ghmartin77/KidsMP3Player/assets/Manual German.pdf

# Kid‘s MP3 Player

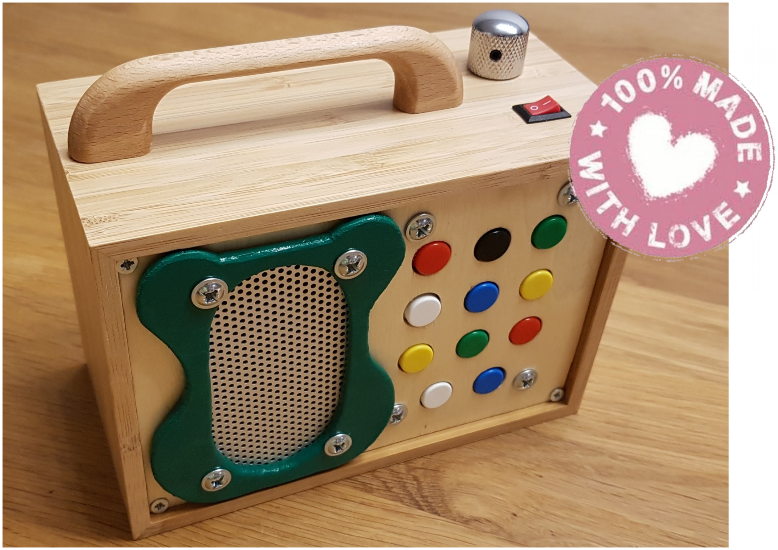
[picture p16: figure]

# Und so geht‘s

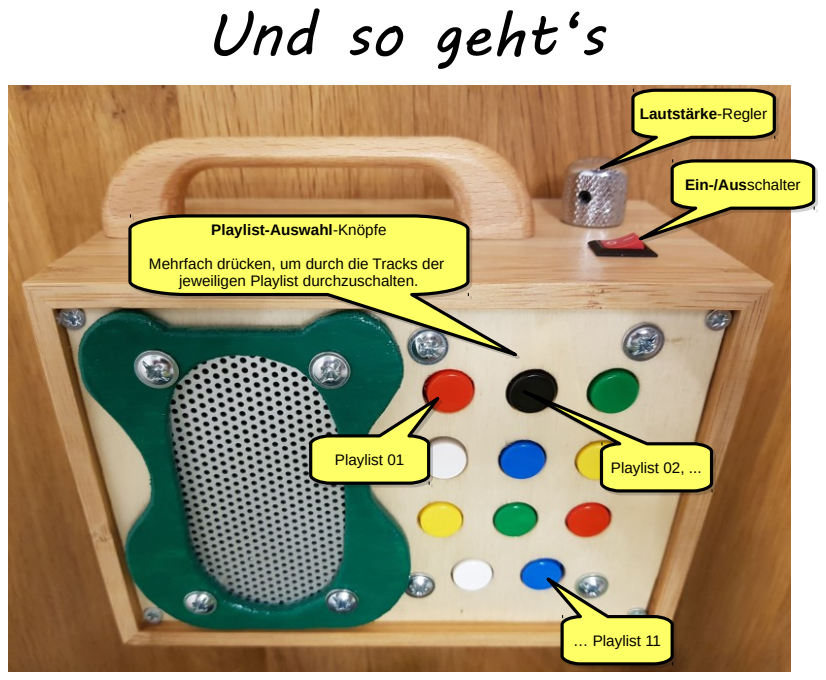
[picture p17: page 2]
Playlist 01 Playlist 01; Playlist 02, ... Playlist 02, ...; … … Playlist 11 Playlist 11

Lautstärke Lautstärke-Regler -Regler

Ein-/Aus Ein-/Ausschalter schalter

Playlist-Auswahl-Knöpfe

Mehrfach drücken, um durch die Tracks der
jeweiligen Playlist durchzuschalten.

# Nur noch 5 Minuten, bütte!

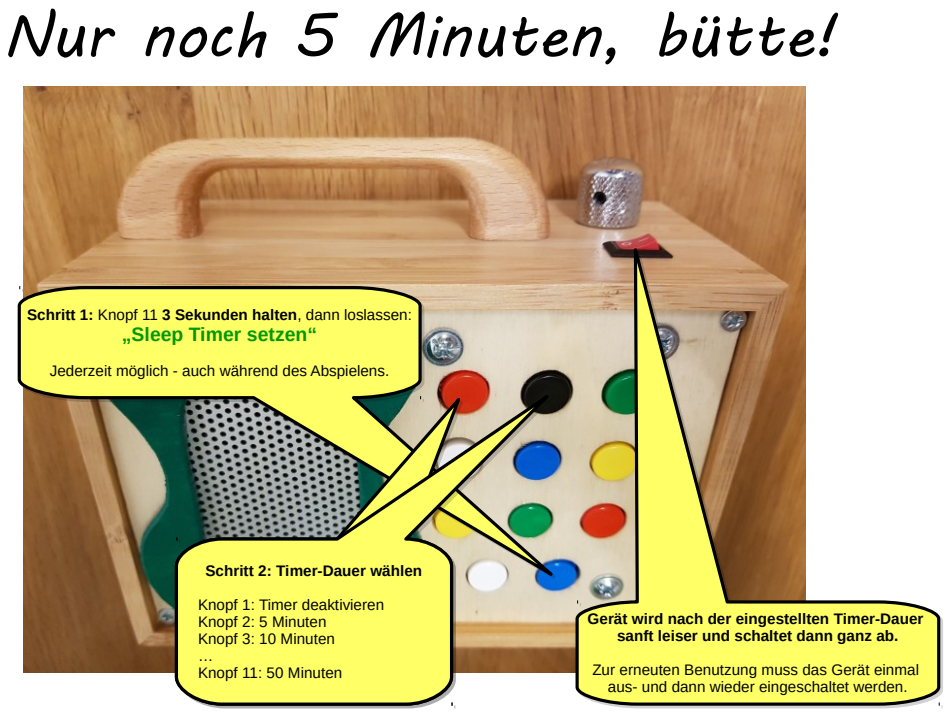
[picture p18: page 3]
Knopf 1: Aus; Knopf 2: 5 Minuten Knopf 3: 10 Minuten; Knopf 11: 50 Minuten

Schritt 1: Knopf 11 3 Sekunden halten, dann loslassen:

„Sleep Timer setzen“

Jederzeit möglich - auch während des Abspielens.

Schritt 2: Timer-Dauer wählen
Knopf 1: Timer deaktivieren
Knopf 2: 5 Minuten
Knopf 3: 10 Minuten
Knopf 11: 50 Minuten

Gerät wird nach der eingestellten Timer-Dauer
sanft leiser und schaltet dann ganz ab.
Zur erneuten Benutzung muss das Gerät einmal
aus- und dann wieder eingeschaltet werden.

# Spiel‘s noch einmal, Sam

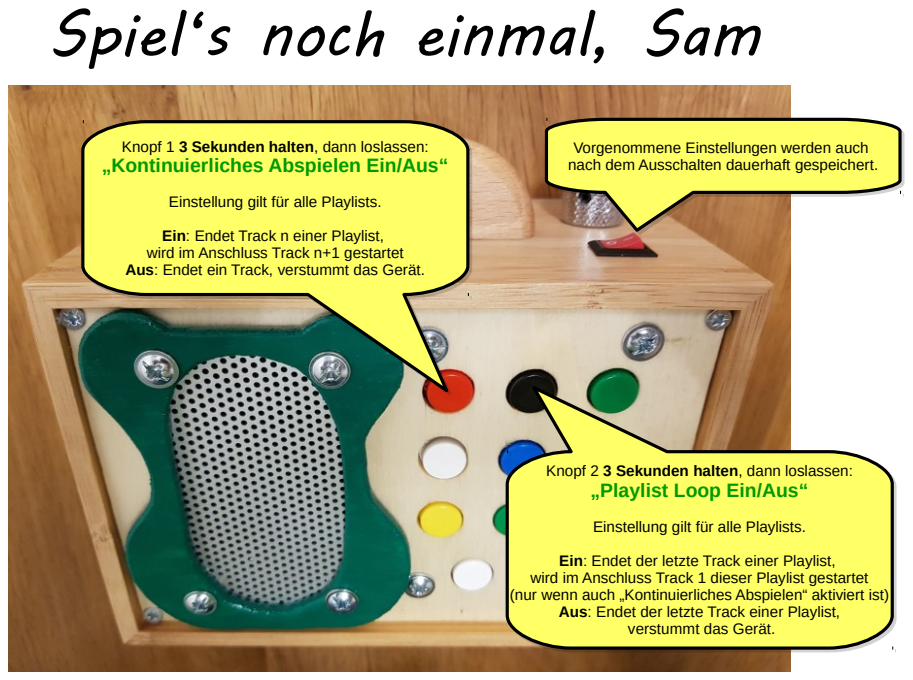
[picture p19: page 4]

Knopf 1 3 Sekunden halten, dann loslassen:
„Kontinuierliches Abspielen Ein/Aus“

Vorgenommene Einstellungen werden auch
nach dem Ausschalten dauerhaft gespeichert.

Einstellung gilt für alle Playlists.
Ein: Endet Track n einer Playlist,
wird im Anschluss Track n+1 gestartet
Aus: Endet ein Track, verstummt das Gerät.

Knopf 2 3 Sekunden halten, dann loslassen:
„Playlist Loop Ein/Aus“

Ein: Endet der letzte Track einer Playlist,
wird im Anschluss Track 1 dieser Playlist gestartet
(nur wenn auch „Kontinuierliches Abspielen“ aktiviert ist)
Aus: Endet der letzte Track einer Playlist,

verstummt das Gerät.

# Offen für alles

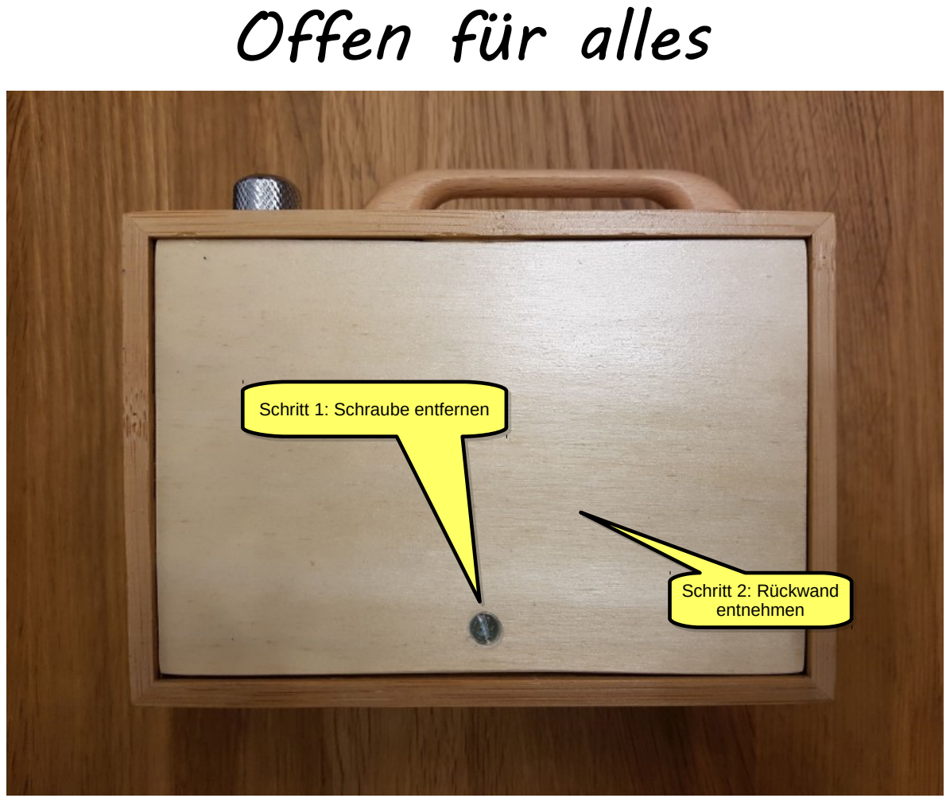
[picture p20: page 5]

Schritt 2: Rückwand
entnehmen

Schritt 2: Rückwand
entnehmen

Schritt 1: Schraube entfernen Schritt 1: Schraube entfernen

# Bin Laden

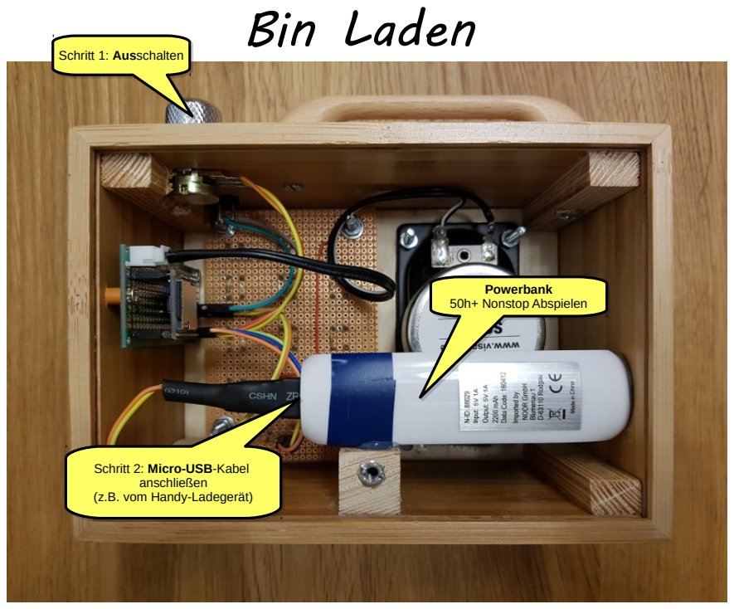
[picture p21: page 6]
anschließen; Powerbank 50h+ Nonstop Abspielen

Schritt 1: Schritt 1: Aus Ausschalten schalten

Schritt 2: Micro-USB-Kabel
(z.B. vom Handy-Ladegerät)

# Sattgehört?

MicroSD-Karte, auf der die Playlists gespeichert sind. Zum Auswerfen und Einsetzen jeweils leicht eindrücken.

ACHTUNG!!! Zuvor Gerät ausschalten!

SD-Adapter-Karte für PC-Reader liegt bei.

MicroSD-Karte, auf der die Playlists gespeichert sind. Zum Auswerfen und Einsetzen jeweils leicht eindrücken.

ACHTUNG!!! Zuvor Gerät ausschalten!

SD-Adapter-Karte für PC-Reader liegt bei.

Ordnerstruktur

\01\ | Ordner für Tracks der Playlist 1
001.mp3 | Track 1 der Playlist 1
002.mp3 | Track 2 der Playlist 1
…
\02\ | Ordner für Tracks der Playlist 2
001.mp3 | Track 1 der Playlist 2
002.mp3 | Track 2 der Playlist 2
…
…
\11\ | Ordner für Tracks der Playlist 11
001.mp3 | Track 1 der Playlist 11

Die Ordnernamen der Playlists dürfen nicht verändert werden! Die Dateinamen der Tracks innerhalb der Playlist müssen dem Namensschema
<dreistellige Nummer mit führenden Nullen>.mp3 entsprechen und je Playlist-Ordner von 1 beginnend hochgezählt werden.

Ordnerstruktur

\01\ | Ordner für Tracks der Playlist 1
001.mp3 | Track 1 der Playlist 1
002.mp3 | Track 2 der Playlist 1
…
\02\ | Ordner für Tracks der Playlist 2
001.mp3 | Track 1 der Playlist 2
002.mp3 | Track 2 der Playlist 2
…
…
\11\ | Ordner für Tracks der Playlist 11
001.mp3 | Track 1 der Playlist 11

Die Ordnernamen der Playlists dürfen nicht verändert werden! Die Dateinamen der Tracks innerhalb der Playlist müssen dem Namensschema
<dreistellige Nummer mit führenden Nullen>.mp3 entsprechen und je Playlist-Ordner von 1 beginnend hochgezählt werden.

# Have It Your Way

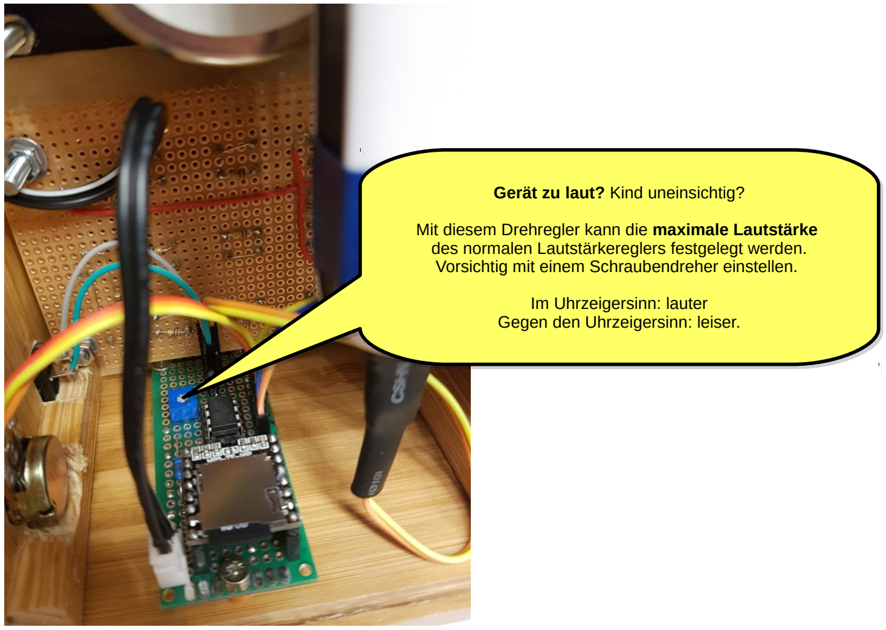
[picture p22: figure]
Gerät zu laut? Kind uneinsichtig?; des normalen Lautstärkereglers festgelegt werden. Vorsichtig mit einem Schraubendreher einstellen.; Im Uhrzeigersinn: lauter Gegen den Uhrzeigersinn: leiser.

Mit diesem Drehregler kann die maximale Lautstärke

Mit diesem Drehregler kann die maximale Lautstärke

# Your Style, Your Rules

Konfigurationsansagen von Tante Google zu hölzern?

Einfach die Dateien unter \ADVERT und \MP3 durch selbst gesprochene Texte austauschen. Dabei Dateinamen und Aussageinhalt beibehalten.

Dateien in \ADVERT und \MP3 müssen identisch sein. Daher Dateien in einem der Ordner aktualisieren und im Anschluss in den anderen Ordner kopieren.

Konfigurationsansagen von Tante Google zu hölzern?

Einfach die Dateien unter \ADVERT und \MP3 durch selbst gesprochene Texte austauschen. Dabei Dateinamen und Aussageinhalt beibehalten.

Dateien in \ADVERT und \MP3 müssen identisch sein. Daher Dateien in einem der Ordner aktualisieren und im Anschluss in den anderen Ordner kopieren.
