ghmartin77/KidsMP3Player/(threads)

Thread 1 (2020-08-25):

pin vol/key swapped?

jlarsch, 2020-08-25:
Hi, nice project. Looking at your code and circuit I get the impression you swapped the pin for volume vs. keys? In the code, you define PIN_KEY A3 but the circuit suggests A3 is connected to potentiometer - and vice versa.

jlarsch, 2020-08-25:
or maybe I misunderstood attiny pin naming?

Thread 2 (2024-04-03):

Using Digispark clone board with ATTinyCore bootloader: Sketch Size is too big!

DiyParts, 2024-04-03:
Hi,
to make it easier for me, I used a Digispark ATT85 board clone to run the project. I used the very small ATTinyCore bootloader https://github.com/SpenceKonde/ATTinyCore . But still: The sketch is too big! Any suggestions?

Der Sketch verwendet 7038 Bytes (106%) des Programmspeicherplatzes. Das Maximum sind 6586 Bytes.
Globale Variablen verwenden 212 Bytes (41%) des dynamischen Speichers, 300 Bytes für lokale Variablen verbleiben. Das Maximum sind 512 Bytes.
Sketch too big; see https://support.arduino.cc/hc/en-us/articles/360013825179 for tips on reducing it.
text section exceeds available space in board
Fehler beim Kompilieren für das Board ATtiny85 (Micronucleus / DigiSpark).
