ghmartin77/KidsMP3Player/(commit log)

2017-11-20 Added schematics for key pad
2017-11-22 Fixed timing issue breaking continuous play
    [KidsMP3Player.ino]
2018-04-17 Introduced subfolder KidsM3Player to be more compliant with ArduinoIDE project structures.
2018-09-15 Added 100nF capacitor for ATTiny
2018-09-16 Added new feature to allow restart of last active track on startup.
2018-09-24 Modified key reference values to match 1kOhm resistors as shown in the schematics. Values still depend on internal pullup but will work if that one is around 36kOhm.
2018-11-11 Removed DFPlayerMini Library in favor of DFMiniMp3 which doesn't suffer from a conceptional problem.
    [DFMiniMp3.h, KidsMP3Player.ino]
2018-11-18 Fixed timing issue at startup which lead to invalid read for the first folder. Additionally changed return values of DFMiniMP3 to express "no reply" which is returned as -1.
    [DFMiniMp3.h, KidsMP3Player.ino]
2019-06-13 Added features: -Repeat1 -"Previous" Button (to be enabled in line 22) -Pause on minimum volume (to be enabled in line 25)
2019-11-12 Fixed playback of active/inactive confirmation for Repeat1 feature
    [KidsMP3Player.ino]
