ghmartin77/KidsMP3Player/(notices)

Notices in the files:
KidsMP3Player/DFMiniMp3.h:
DFMiniMp3 is free software: you can redistribute it and/or modify
it under the terms of the GNU Lesser General Public License as
published by the Free Software Foundation, either version 3 of
the License, or (at your option) any later version.
